AjCodes/Smart-Roads/(commit log)

2025-11-15 Fix links in README.md for backend, dashboard, and Arduino
2025-11-15 Remove team attribution from README
    Removed the 'Made with ❤️ by the Smart Roads Team' line.
2025-11-15 updated dashboard and esp32 readme
2025-11-21 fixed the connections between backend , esp32 and the dashboard
    [main.cpp]
2025-11-27 Update README with ESP32 simulation instructions
    Added simulation step for ESP32 in README.
2025-11-27 Correct ESP32 instructions formatting
    Fix formatting for ESP32 section in README.
2025-11-27 Include simulation command for ESP32
    Add simulation instructions for ESP32 project.
2025-12-03 fixed the esp32 code
    [main.cpp]
2025-12-04 updated sensor distance limit
2025-12-05 done working prototype
2025-12-05 adjusted timer
